ChnTamap/ObsCar/ObsCar.ioc

Mcu.UserName=STM32F103C8Tx
PA0-WKUP.GPIO_Label=DIS0_TRIG
PA0-WKUP.Signal=S_TIM2_CH1_ETR
PA1.GPIO_Label=DIS0_ECHO
PA1.Signal=S_TIM2_CH2
PA10.Signal=USART1_RX
PA13.Signal=SYS_JTMS-SWDIO
PA14.Signal=SYS_JTCK-SWCLK
PA2.GPIO_Label=DIS1_TRIG
PA2.Signal=S_TIM2_CH3
PA3.GPIO_Label=DIS1_ECHO
PA3.Signal=S_TIM2_CH4
PA4.GPIO_Label=Key0
PA4.Signal=GPXTI4
PA5.GPIO_Label=Key1
PA5.Signal=GPXTI5
PA6.GPIO_Label=Servo0
PA6.Signal=S_TIM3_CH1
PA7.Signal=S_TIM3_CH2
PA9.Signal=USART1_TX
PB0.Signal=S_TIM3_CH3
PB1.Signal=S_TIM3_CH4
PB10.GPIO_Label=Encode0
PB10.Signal=GPXTI10
PB11.GPIO_Label=Encode1
PB11.Signal=GPXTI11
PB12.GPIO_Label=DEBUG1
PB12.Signal=GPIO_Output
PB13.GPIO_Label=DEBUG2
PB13.Signal=GPIO_Output
PB3.GPIO_Label=NearL1
PB3.Signal=GPIO_Input
PB4.GPIO_Label=NearL2
PB4.Signal=GPIO_Input
PB5.GPIO_Label=NearR1
PB5.Signal=GPIO_Input
PB6.GPIO_Label=NearR2
PB6.Signal=GPIO_Input
PB8.Signal=I2C1_SCL
PB9.Signal=I2C1_SDA
PC13-TAMPER-RTC.GPIO_Label=LED
PC13-TAMPER-RTC.Signal=GPIO_Output
PD0-OSC_IN.Signal=RCC_OSC_IN
PD1-OSC_OUT.Signal=RCC_OSC_OUT
