ChnTamap/ObsCar/(commit log)

2019-05-12 实现了: MPU6050的纯陀螺仪积分姿态解算 舵机控制 串口/无线串口的终端显示/蓝牙协议显示 LED状态指示
2019-05-20 编写了PID算法的文件PID.c,PID.h 增加了码盘计数(EXIT PB10 PB11)
2019-06-01 添加了Readme.md。 完成了初步的完整规划。 将陀螺仪姿态解算结果改成输出弧度而不是角度。 完成了直线行走的PID程序。 目前还存在超声波偶尔跳变数值的BUG（未知原因，受环境影响） 下一步计划编写动态校准和避障程序。
2019-06-11 修改了超声波TRIG高电平时间 添加了串口调参操作
2019-06-11 做好了参数调整界面
2019-06-12 修改了初始转向方向和光电传感器程序的小bug
2019-06-12 Readme|重置|终端|防撞转向|IO上拉 更新了Readme 添加了用户的重置功能 优化了串口终端 添加了前方同时检测到的转向逻辑（可能会出问题，待测试） 将按键GPIO修改为上拉模式
    [ObsCar.ioc]
2019-06-18 回转|更新.md 添加了缓解过度转向的回转动作及其角度设置。 更新readme。 修正错字。
2019-06-18 删除文件
2019-09-11 将项目中文件编码格式从GB转为 UTF-8
2019-09-11 修复了一点关于回转的bug
2019-09-18 修复了BUG！
2019-09-20 添加了部分调试信息，修改了Dis_Diff的初始值
2019-10-21 转向LOG;优化BLE软件支持;修改默认参数
2019-10-22 添加避障阶段最大转向角机制（测试）
2019-10-23 测试: 将最大转向后回转改为直走 | 即将经过障碍直走改为回正
2019-10-24 修改初始参数 | 将避障角度max后回转修改为不回转（测试）
2019-10-25 取消角度重置 | 修复经过障碍回转时前方红外会影响的BUG | 修复GUI的BUG
2019-10-25 添加了遥控测试功能
2019-10-27 修复乱码
